XDleader555/monsoon/cad/Monsoon Schematic.pdf

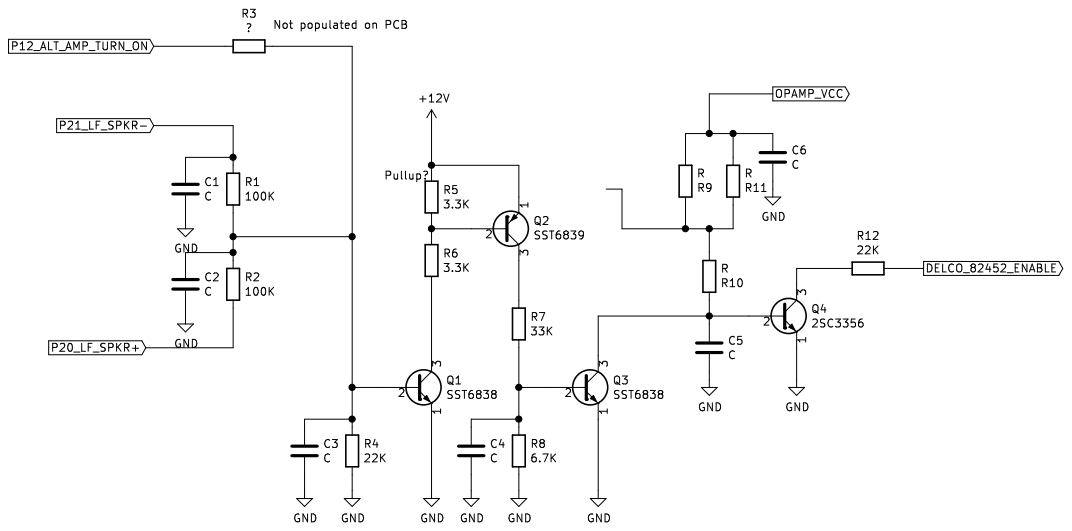
[picture p4: page 1]
