XDleader555/monsoon/res/Connector.jpg

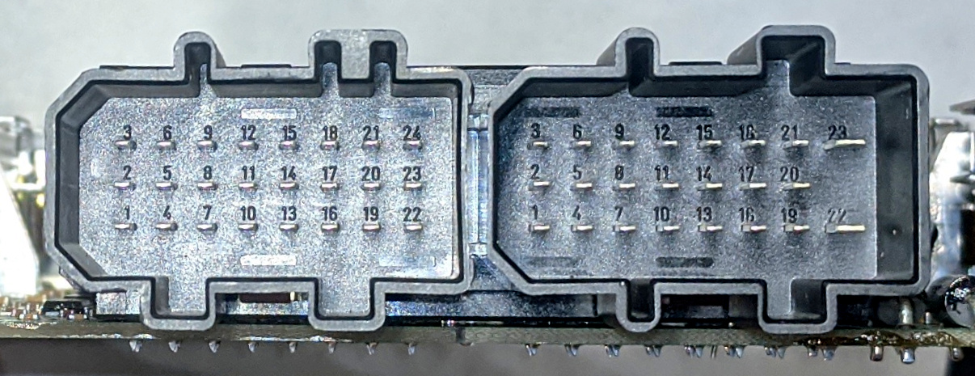
res/Connector.jpg
